YumK00/can-vehicle-platform/host/mobile-app/car.jpg

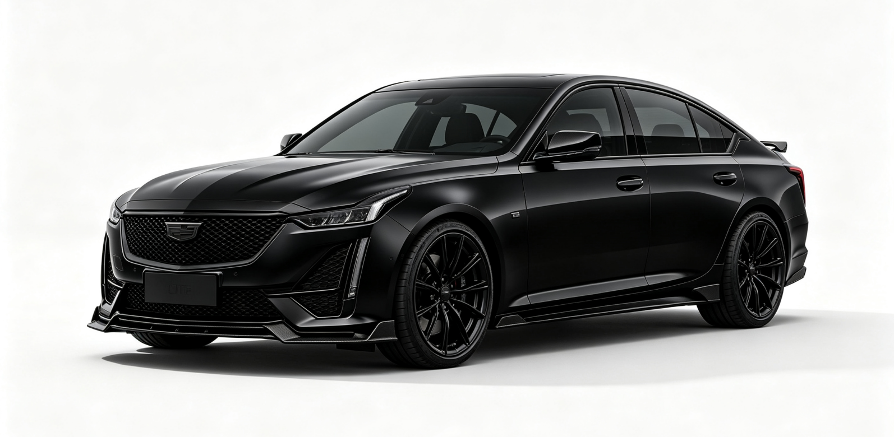
host/mobile-app/car.jpg
