YumK00/can-vehicle-platform/docs/can-protocol-and-wiring.md

# 通信协议设计 & 接线图（CAN + MQTT）v3.0

> **本文职责**：**协议全量定义** —— 帧格式、字节布局、滤波器、接线图、上电检查。
> 写代码时的速查映射见 `网关收发速查表.md`；入口见 `项目总纲.md`。
>
> **项目**：工业边缘智能网关（STM32F103 × N + ESP32-S3 网关）
> **节点**：`11111` = 节点 A（传感器） ｜ `22222` = 节点 B（执行器） ｜ ESP32-S3 = 网关
> **用途**：A、B、网关、USB-CAN 上位机都按本文档收发，抓帧就能对上号。
> **版本**：v3.0（修正 CAN ID 分配缺陷 + 重做 MQTT 主题设计）

---

# 〇、v2.0 → v3.0 修正了什么

审了一遍，**两处都是真问题**，不是审美偏好。

## 问题 1：CAN ID 按"节点"分组，扩展性和滤波都差

v2.0 的方案：A 用 `0x1xx`、B 用 `0x2xx`、控制指令用 `0x3xx`。

| 缺陷 | 后果 |
|---|---|
| **节点 C 没地方放** | `0x1xx`/`0x2xx` 给了 A/B，`0x3xx` 被控制指令占了 → 第三个节点只能挤到 `0x5xx`，很别扭 |
| **同类消息分散** | A 心跳 `0x180`、B 心跳 `0x280` 在不同组 → 网关想"收全所有心跳"，需要配**两个**滤波器组 |
| **两个维度混用** | 高 4 位有时表示节点（`0x1xx`）、有时表示功能（`0x3xx`）→ 规则不统一，没法一句话讲清 |

**根因**：我把「按节点分组」和「按功能分组」混在一起了。

**修正**：统一成 **按功能分组，节点号放低 4 位**。

## 问题 2：MQTT 主题把"传输方式"写进了层级

v2.0 的方案：`home/can/nodeA/sensor`、`home/can/cmd/motor`。

| 缺陷 | 后果 |
|---|---|
| **`can` 出现在主题里** | 阶段 1 加 Modbus 后，主题变成 `home/modbus/...`？→ 同一批数据分裂成两棵树 |
| **下行主题不含目标设备** | `home/can/cmd/motor` 所有设备都收到，靠 payload 里的 `target` 过滤 → 浪费带宽、容易误执行 |
| **没有 QoS / retained / LWT 约定** | 最危险的是**命令主题误用 retained**：新设备一连上就收到历史"开电机"命令并执行 |
| **`home` 前缀在公共 broker 上会撞车** | `broker.emqx.io` 是公共的，别人也能订阅 `home/#` 看到你的数据 |

**修正**：改成 `{项目前缀}/{网关}/{设备}/{类型}`，并补齐 QoS / retained / LWT 约定。

## 好消息：改动成本极低

你的代码里 ID 全是 **宏**（`CAN_ID_A_SENSOR`），MQTT 主题还没写进代码。

**所以这次修正只需要改 `protocol.h` 一个文件，不动任何业务逻辑。**

---

# 第一部分 · 总线物理层约定

| 项目 | 约定值 | 说明 |
|---|---|---|
| 帧格式 | **CAN 2.0A 标准帧**（11 位 ID） | 不用扩展帧 |
| 波特率 | **250 kbps** | 所有节点必须一致 |
| 位定时 | Prescaler=9、BS1=13TQ、BS2=2TQ、SJW=2TQ | `36MHz/(9×16)=250k`，采样点 87.5% |
| 模式 | **Normal**（两边都是） | ❌ 不用 Listen-Only，那样不回 ACK，对方会进 bus-off |
| 拓扑 | 总线型（手拉手），不要星型 | 分支线 < 30cm |
| 线材 | 双绞线（CANH/CANL 一对） | |
| 终端电阻 | **120Ω × 2**，加在物理最远两端 | 中间节点不加 |
| 共地 | **所有节点必须共 GND** | |

---

# 第二部分 · CAN ID 分配（v3.0 新方案）

## 2.1 ID 结构

```
 bit:  10  9  8  7  6  5  4 │ 3  2  1  0
      ┌────────────────────┼───────────┐
      │   功能组（高 7 位） │ 节点号(4位)│
      └────────────────────┴───────────┘
```

**节点号**：`0` = 广播 ｜ `1` = 节点A ｜ `2` = 节点B ｜ `3` = 网关 ｜ `4~15` 预留

**功能组**（ID 越小优先级越高）：

| 功能组 | ID 形式 | 用途 | 优先级 | 周期 |
|---|---|---|---|---|
| 紧急安全 | `0x001` | 急停（固定 ID，广播） | **最高** | 事件 |
| 事件报警 | `0x01n` | 阈值触发、故障 | 高 | 事件 |
| 周期数据 | `0x10n` | 传感器数据、执行器状态、网关状态 | 中高 | 100~1000ms |
| 控制指令 | `0x30n` | 电机命令（目标 = n） | 中 | 事件 |
| | `0x31n` | 目标值 / 阈值（目标 = n） | 中 | 事件 |
| | `0x32n` | PID 参数（目标 = n） | 中低 | 事件 |
| | `0x33n` | 模式 / 配置（目标 = n） | 中低 | 事件 |
| 心跳 | `0x70n` | 心跳（n = 节点） | 低 | 1000ms |
| 诊断升级 | `0x7E0` / `0x7E8` | 请求 / 应答（UDS 惯例） | 最低 | 事件 |

> **优先级设计理由**：
> 1. 急停最高 → 永远赢仲裁，不会被数据帧挤掉
> 2. 报警高于数据 → 异常要立刻出去，不能等下一个周期帧
> 3. 数据高于指令 → 周期数据是闭环控制的输入，硬实时；指令是事件性的，人感知不到 1ms 级差异
> 4. 心跳最低 → 1Hz、超时判定 3 秒，延迟几百 ms 完全无影响（CANopen 也把心跳放在最低组 `0x700+n`）
> 5. 诊断最低 → 只在维护时用

## 2.2 本项目实际用到的 ID

**✅ = 现在就要用 ｜ ⬜ = 预留（阶段 2/4 再实现）**

| ID | 名称 | 方向 | DLC | 周期 | 状态 |
|----|---|---|-----|---|---|
| `0x001` | `ESTOP` 急停 | 任意 → 广播 | 1 | 事件 | ✅ |
| `0x011` | `ALARM_A` | A → 广播 | 3 | 事件 | ⬜ |
| `0x012` | `ALARM_B` | B → 广播 | 3 | 事件 | ⬜ |
| `0x101` | `A_SENSOR` 传感器数据 | A → 广播 | 5 | 100ms | ✅ |
| `0x102` | `B_STATUS` 执行器状态 | B → 广播 | 4 | 200ms | ✅ |
| `0x103` | `GW_STATUS` 网关状态 | 网关 → 广播 | 4 | 1000ms | ✅ |
| `0x301` | `CTRL_MOTOR` → 节点A | → A | 3 | 事件 | ⬜ |
| `0x302` | `CTRL_MOTOR` → 节点B | → B | 3 | 事件 | ✅ |
| `0x311` | `CTRL_TARGET` → 节点A | → A | 3 | 事件 | ⬜ |
| `0x312` | `CTRL_TARGET` → 节点B | → B | 3 | 事件 | ✅ |
| `0x322` | `CTRL_PID` → 节点B | → B | 7 | 事件 | ⬜ |
| `0x332` | `CTRL_MODE` → 节点B | → B | 2 | 事件 | ⬜ |
| `0x701` | `A_HEARTBEAT` | A → 广播 | 2 | 1000ms | ✅ |
| `0x702` | `B_HEARTBEAT` | B → 广播 | 2 | 1000ms | ✅ |
| `0x703` | `GW_HEARTBEAT` | 网关 → 广播 | 2 | 1000ms | ✅ |
| `0x7E0` | `DIAG_REQ` 诊断/升级请求 | → 目标 | ≤8 | 事件 | ⬜ |
| `0x7E8` | `DIAG_RSP` 诊断/升级应答 | 目标 → | ≤8 | 事件 | ⬜ |

> **从 v2.0 迁移**：`A_SENSOR 0x100→0x101`、`B_STATUS 0x200→0x102`、`A_HB 0x180→0x701`、`B_HB 0x280→0x702`。**只改 `protocol.h`。**

## 2.3 加节点有多容易（这就是修正的价值）

想加一个"节点 C（电流采集）"：

```
0x10C   节点C 的周期数据
0x70C   节点C 的心跳
0x30C   给节点C 的控制指令
```

**只加 3 个宏，分组规则一个字不用改。** v2.0 方案下你得重新想"0x5xx 还是插进 0x1xx"。

---

# 第三部分 · 帧定义

## 3.1 `0x101` A_SENSOR（核心帧）

| 字节 | 内容 | 说明 |
|---|---|---|
| B0 | 红外 **高**字节 | uint16 **大端** |
| B1 | 红外 **低**字节 | |
| B2 | 光敏 **高**字节 | uint16 **大端** |
| B3 | 光敏 **低**字节 | |
| B4 | 序列号 SEQ | 0~255 循环，用于丢帧统计 |

- **DLC = 5**，周期 **100ms**
- **方向提醒**：光敏读数越大 = **越暗**；红外读数越大 = **无遮挡**

## 3.2 `0x102` B_STATUS

| 字节 | 内容 | 取值 |
|---|---|---|
| B0 | 电机状态 | 0=停 ／ 1=正转 ／ 2=反转 |
| B1 | PWM | 0~100 |
| B2 | 工作模式 | 0=手动 ／ 1=自动(PID) |
| B3 | 状态位 | bit0 通信正常 ／ bit1 阈值触发 ／ bit2 报警 |

- **DLC = 4**，周期 **200ms**

## 3.3 `0x103` GW_STATUS

| 字节 | 内容 | 取值 |
|---|---|---|
| B0 | WiFi 状态 | 0=断 ／ 1=连 |
| B1 | MQTT 状态 | 0=断 ／ 1=连 |
| B2-B3 | 缓存条数 | uint16 大端（断网缓存里积压多少条） |

- **DLC = 4**，周期 **1000ms**

## 3.4 心跳 `0x701` / `0x702` / `0x703`

| 字节 | 内容 |
|---|---|
| B0 | 魔数：A=`0xA5` ／ B=`0x5A` ／ 网关=`0xC3` |
| B1 | 心跳计数 0~255 |

- **DLC = 2**，周期 **1000ms**

## 3.5 `0x001` ESTOP 急停

| 字节 | 内容 |
|---|---|
| B0 | `0x01` |

- **DLC = 1**，事件触发
- ID 最小 → **总线上必赢仲裁**，永远不会被数据帧挤掉

## 3.6 `0x302` CTRL_MOTOR → B

| 字节 | 内容 | 取值 |
|---|---|---|
| B0 | 命令 | 0=停 ／ 1=正转 ／ 2=反转 ／ 3=设速 |
| B1 | 参数 | 速度 0~100 |
| B2 | 命令序号 | 0~255，用于幂等/去重 | 

> **注意**：v2.0 里 B0 是"目标节点"，**新方案里目标节点已经在 ID 低 4 位了**，所以 B0 空出来给命令。
> **这就是分组的价值**：ID 表达"发给谁"，payload 表达"干什么"，职责不重叠。

## 3.7 `0x312` CTRL_TARGET → B

| 字节 | 内容 |
|---|---|
| B0-B1 | 目标光照值（uint16 大端，0~4095） |
| B2 | 命令序号 |

## 3.8 `0x322` CTRL_PID → B（预留）

| 字节 | 内容 |
|---|---|
| B0-B1 | Kp × 100（uint16 大端） |
| B2-B3 | Ki × 100 |
| B4-B5 | Kd × 100 |
| B6 | 命令序号 |

## 3.9 `0x332` CTRL_MODE → B（预留）

| 字节 | 内容 |
|---|---|
| B0 | 模式 0=手动 ／ 1=自动 |
| B1 | 命令序号 |

## 3.10 `0x011` / `0x012` ALARM（预留，阶段 2）

| 字节 | 内容 |
|---|---|
| B0 | 报警码（1=传感器故障 2=通信丢失 3=阈值越界 4=执行器故障） |
| B1 | 附加数据高字节 |
| B2 | 附加数据低字节 |

- **为什么要独立于状态帧**：报警要**立刻**发出，不能等下一个 200ms 状态帧。这是实时性设计。

---

# 第四部分 · 编码约定与示例

## 4.1 约定

- **多字节一律大端**（高字节在前），与 CANopen / J1939 一致
- **传感器值**：直接用 ADC 原始值 0~4095（uint16）
- **百分比**：uint8，0~100
- **PID 参数**：uint16 = 实际值 × 100，不允许负数
- **序列号**：uint8，每发一帧 +1，到 255 归 0
- **魔数**：A=`0xA5`、B=`0x5A`、网关=`0xC3`
- **未定义的 ID 一律静默忽略**

## 4.2 字节级示例（拿 USB-CAN 一比就对）

| 场景 | 抓到的帧 | 解读 |
|---|---|---|
| 红外 3854、光敏 1030、第 7 帧 | `0x101` DLC=5 `0F 0E 04 06 07` | 0x0F0E=3854；0x0406=1030；SEQ=7 |
| 红外被挡 | `0x101` DLC=5 `00 B4 04 06 08` | 0x00B4=180 |
| B 正转 60% | `0x102` DLC=4 `01 3C 00 01` | 正转；0x3C=60；手动；通信正常 |
| 网关：WiFi+MQTT 都连上、缓存 12 条 | `0x103` DLC=4 `01 01 00 0C` | 0x000C=12 |
| A 心跳第 3 次 | `0x701` DLC=2 `A5 03` | |
| 手机让 B 正转 60% | `0x302` DLC=3 `01 3C 05` | 命令1=正转；速度60；序号5 |
| 下发目标光照 3000 给 B | `0x312` DLC=3 `0B B8 06` | 0x0BB8=3000 |
| 急停 | `0x001` DLC=1 `01` | |

**验算**：3854=0x0F0E ✓ ｜ 1030=0x0406 ✓ ｜ 3000=0x0BB8 ✓ ｜ 12=0x000C ✓

---

# 第五部分 · 接收滤波器（新方案下好配多了）

## 5.1 32 位掩码模式的正确写法

标准 ID 必须**左移 5 位**放进高半字 —— 这是最容易写错的地方。

```c
/* 精确匹配单个 ID */
#define FLT_ID(id)    ((uint32_t)(id) << 5)
/* 匹配"功能组"，忽略低 4 位节点号：掩码高 7 位全 1，低 4 位全 0 */
#define FLT_GROUP(id) ((uint32_t)((id) & 0x7F0) << 5)
```

## 5.2 各节点的滤波器配置

| 节点 | 想接收 | 滤波器组 | FilterIdHigh | FilterMaskIdHigh |
|---|---|---|---|---|
| **A** | 急停 `0x001` | Bank 0 | `0x001<<5` = `0x0020` | `0x7FF<<5` = `0xFFE0` |
| | 发给 A 的控制 `0x30n~0x33n` | Bank 1 | `0x300<<5` = `0x6000` | `0x700<<5` = `0xE000` |
| | 网关心跳 `0x703` | Bank 2 | `0x703<<5` = `0xE060` | `0xFFE0` |
| **B** | 急停 `0x001` | Bank 0 | `0x0020` | `0xFFE0` |
| | **A 的所有周期数据 + 心跳** `0x10n`、`0x70n` | Bank 1 | 见下 | |
| | 发给 B 的控制 `0x30n~0x33n` | Bank 2 | `0x6000` | `0xE000` |
| **网关** | 全部 | — | `ACCEPT_ALL` | 网关要做协议翻译，全收 |

**Bank 1（B 收 A 的数据）需要两个匹配**：`0x10x` 和 `0x70x`。因为它们是两个不同的功能组，用**列表模式**更合适：

```c
/* 列表模式：一次配两个精确 ID */
sFilterConfig.FilterMode      = CAN_FILTERMODE_IDLIST;
sFilterConfig.FilterScale     = CAN_FILTERSCALE_32BIT;
sFilterConfig.FilterIdHigh    = (0x101 << 5);   /* 第一个 ID */
sFilterConfig.FilterIdLow     = (0x701 << 5);   /* 第二个 ID */
sFilterConfig.FilterMaskIdHigh= 0;
sFilterConfig.FilterMaskIdLow = 0;
```

> **这就是分组的价值体现**：v2.0 里 A 的心跳 `0x180` 和数据 `0x100` 虽然同组，但 B 的心跳 `0x280` 却在另一组，网关想收全心跳必须配两个组。新方案里 `0x70n` 就是"所有心跳"，一个掩码搞定。

> **建议**：先别急着收紧滤波器。用 `ACCEPT_ALL` 把链路跑通，**确认收发正常后再收紧** —— 否则你会分不清"是滤波器配错"还是"根本没通信"。

---

# 第六部分 · MQTT 主题设计

> **完整的主题表与下行命令清单见 `网关收发速查表.md` 第 4、5 节**，
> 本节只讲**设计原则和理由**，不重复表格。

## 6.1 主题结构（已实现的方案）

```
{前缀} / {设备} / {类型}

 gw01  / nodeA  / telemetry
```

- **前缀**：`MQTT_PREFIX` 一个宏，含网关标识（当前 `"gw01"`）
- **设备**：`nodeA` / `nodeB` / `gateway` ／ 下行另有 `all`
- **类型**：上行 `telemetry` / `alert` / `status` / `stats`；下行 `cmd/<命令类型>`

> **完整前缀 = `gw01`**（代码里的 `MQTT_PREFIX` 宏），三个节点共用同一棵主题树。

## 6.2 上行主题（设备 → 云）

| 主题 | QoS | Retained | 触发 | 状态 |
|---|-----|---|---|---|
| `{p}/nodeA/telemetry` | 0 | ❌ | 收到 CAN `0x101` | ✅ 已实现 |
| `{p}/nodeB/telemetry` | 0 | ❌ | 收到 CAN `0x102` | ✅ 已实现 |
| `{p}/nodeA/alert` | 0 | ❌ | 收到 CAN `0x011` | ✅ 已实现 |
| `{p}/nodeB/alert` | 0 | ❌ | 收到 CAN `0x012` | ✅ 已实现 |
| `{p}/gateway/status` | 0 | ❌ | 每 5 秒 | ✅ 已实现 |
| `{p}/nodeA/status` | 1 | **✅** | 在线状态**翻转时** | ⬜ 待做 |
| `{p}/nodeB/status` | 1 | **✅** | 同上 | ⬜ 待做 |
| `{p}/gateway/stats` | 0 | ❌ | 每 10 秒 | ⬜ 待做（阶段 2） |

> **为什么 `telemetry` 不用 retained**：高频数据，retained 只保留最后一条，没意义还占 broker 存储。
> **为什么 `status` 要用 retained**：新订阅者一连上就立刻知道设备当前状态，不用干等下一次心跳。

## 6.3 下行主题：命令类型放主题里，不用 JSON ⭐

**实际实现**：

```
{p}/{节点}/cmd/{命令类型}          网关订阅  {p}/+/cmd/#

{p}/nodeB/cmd/motor     payload "1,50"        → 0x302
{p}/nodeB/cmd/target    payload "2000"        → 0x312
{p}/nodeB/cmd/pid       payload "1.5,0.2,0"   → 0x322
{p}/nodeB/cmd/mode      payload "1"           → 0x332
{p}/all/cmd/estop       payload 任意           → 0x001
```

**为什么这样比"单一 cmd 主题 + JSON payload"好**：

| | 单一 cmd + JSON | **主题分层 + 纯数据**（已采用） |
|---|---|---|
| MCU 侧代码 | 要写 JSON 解析器 | **零解析，`sscanf` 几行搞定** |
| 内存占用 | 解析器 + 缓冲 | 几乎为零 |
| 可读性 | 展开 JSON 才知道干什么 | 看主题就知道 |
| 通配订阅 | 只能全订 | 可精确订 `+/cmd/motor` |

CAN 侧已经按功能组拆好了（`GRP_CTRL_MOTOR` / `GRP_CTRL_PID`…），
MQTT 侧跟着拆，是**同一套划分的两个出口**。

> **完整命令清单（7 条，含 payload 取值）见 `网关收发速查表.md` 第 5 节。**

> ⚠️ **`all` 只建议用于 `estop`**：广播控制动作很危险（"所有节点一起开电机"基本不是你想要的），
> 而且会生成协议里没定义的 `0x300`。建议在 `can_bridge_mqtt` 里加一条限制。

## 6.4 ⚠️ 命令主题绝对不能 retained

retained 会让**每一个新订阅者一连上就收到最后一条命令并执行**。
想象一下网关重启后立刻执行三天前的"电机正转"——**这是 MQTT 主题设计里最经典的坑**。

→ 发命令时 `retain` 必须传 **0**。

## 6.5 订阅关系

| 谁 | 订阅 | 收到什么 |
|----|---|---|
| **网关** | `{p}/+/cmd/#` | 所有设备的命令 |
| **手机 App** | `{p}/#` | 全部 |
| **数据入库** | `{p}/+/telemetry` | 只收遥测 |
| **告警看板** | `{p}/+/alert` | 只收告警 |

## 6.6 LWT 遗嘱（⬜ 待做）

连接 broker 时声明遗嘱：**网关断线时 broker 自动代为发布**。

```c
static char s_lwt_topic[64];      /* ★ 必须 static：cfg 里存的是指针 */
snprintf(s_lwt_topic, sizeof(s_lwt_topic), "%s/gateway/status", MQTT_PREFIX);

esp_mqtt_client_config_t cfg = {
    .broker.address.uri = "mqtt://broker.emqx.io",
    .session.last_will = {
        .topic   = s_lwt_topic,
        .msg     = "{\"online\":false}",
        .msg_len = 16,
        .qos     = 1,
        .retain  = 1,          /* ★ 必须 retained，否则新订阅者看不到 */
    },
};
```

**效果**：网关一掉线，broker 立刻把 `gateway/status` 改成 `{"online":false}`，
**云端不需要自己判超时** —— 这是 MQTT 最实用的特性之一，面试可以讲。

## 6.7 Payload 设计

**已实现的 payload**（紧凑 JSON，不带空格，省带宽）：

```json
// {p}/nodeA/telemetry
{"ir":3854,"ldr":1030,"seq":42}

// {p}/nodeB/telemetry
{"motor":1,"pwm":60,"mode":0,"flags":1}

// {p}/nodeA/alert   ·   {p}/nodeB/alert
{"code":2,"extra":0}

// {p}/gateway/status
{"wifi":1,"mqtt":1,"cache":0}
```

**待做的 payload**（阶段 2）：

```json
// {p}/gateway/stats        —— 丢帧率统计做完后
{"rx":1234,"lost":3,"lost_rate":0.0024,"mqtt_drop":0,"uptime":3600,"heap":123456}

// {p}/nodeA/status（retained）
{"online":true,"lastseen":1696234567}
```

### 关于时间戳（⬜ 待做，一个真实的工程问题）

STM32 **没有 RTC，也没有对时**，所以只能提供**上电后的相对毫秒数**。现在的 payload 里没有时间戳。

**解决方案**：
- CAN 帧里带的是设备相对时间（用于算丢帧/间隔）
- **网关收到后用自己 SNTP 同步的 UTC 时间补上 `ts_gw`**，作为云端记录的依据

> 这就是"网关做语义转换"的具体体现 —— 它不只是转发，还负责**补全设备缺的信息**。
> 面试可以讲：*"设备无 RTC，时间戳由网关统一打，保证云端时序一致。"*

## 6.8 心跳要不要转发到 MQTT？

**不转发。** 设计决策：

- 心跳是**链路层**的存活检测，每秒一帧 × N 个节点，全转发到云端是纯浪费
- 网关自己判超时，然后**更新对应节点的 `status`（retained）里的 `online` 字段**
- 云端只看 retained 的 status 消息就知道在不在线

**收益**：MQTT 消息量大幅下降，云端也不用自己维护超时定时器。

---

# 第七部分 · CAN ↔ MQTT 映射表

| CAN 帧 | MQTT 主题 | 处理方式 |
|---|---|---|
| `0x101` A_SENSOR | `{p}/gw01/nodeA/telemetry` | 解析 → JSON → 发布 |
| `0x102` B_STATUS | `{p}/gw01/nodeB/telemetry` | 解析 → JSON → 发布 |
| `0x103` GW_STATUS | `{p}/gw01/gateway/status` | 合并进网关状态 |
| `0x701` A_HEARTBEAT | （**不转发**） | 只用于刷新 nodeA 的 online 状态 |
| `0x702` B_HEARTBEAT | （**不转发**） | 同上 |
| `0x703` GW_HEARTBEAT | （**不转发**） | 网关自身 |
| `0x001` ESTOP | `{p}/gw01/alert` | level=critical |
| `0x011/0x012` ALARM | `{p}/gw01/alert` | 预留 |
| — | `{p}/gw01/gateway/stats` | 网关本地统计，10 秒发一次 |
| `{p}/gw01/nodeB/cmd` | `0x302` / `0x312` / `0x322` | 按 `cmd` 字段选帧 |
| `{p}/gw01/broadcast/cmd` | `0x001` | 急停 |

**下行映射规则**：

| JSON 的 `cmd` | 发出的 CAN 帧 |
|---|---|
| `motor` | `0x302`（目标 B） |
| `target` | `0x312` |
| `pid` | `0x322` |
| `mode` | `0x332` |
| `estop` | `0x001` |

---

# 第八部分 · ⚠️ 现有代码的两个风险

## 8.1 `CAN_Send()` 里的 `Error_Handler()` 会死机

```c
if (HAL_CAN_AddTxMessage(...) != HAL_OK) Error_Handler();   // ← 危险
```

`Error_Handler()` = `__disable_irq(); while(1);`

**邮箱满（3 个发送邮箱都在用）是完全正常的情况**，不是致命错误。改成：

```c
uint8_t CAN_Send(uint32_t id, uint8_t *data, uint8_t length)
{
    if (length > 8) return 0;
    if (HAL_CAN_GetTxMailboxesFreeLevel(&hcan1) == 0) return 0;   /* 丢帧，不卡死 */
    ...
    return (HAL_CAN_AddTxMessage(...) == HAL_OK) ? 1 : 0;
}
```

## 8.2 两个节点的 `AutoRetransmission` 不一致

| 工程 | 当前 | 建议 |
|---|---|---|
| `11111` | `DISABLE` | 保持 |
| `22222` | `ENABLE` | **改成 `DISABLE`** |

**为什么**：B 加上心跳后，如果 A 关机，B 的心跳永远拿不到 ACK → `ENABLE` 会**无限重发** → 3 个邮箱占满 → `AddTxMessage` 失败 → 触发 8.1 的死循环。

---

# 第九部分 · 时序与安全

## 9.1 心跳与超时

```
A ──0x701(1s)──▶ 总线
B ──0x702(1s)──▶ 总线
网关 ──0x703(1s)──▶ 总线

B 端：3 秒收不到 0x701 → A 离线 → 停电机、LED 熄、OLED 显示"通信丢失"
A 端：3 秒收不到 0x702 → B 离线 → 报警
网关：任一节点心跳丢失 → 更新该节点 status 的 online=false → 发 alert
```

超时阈值 = 心跳周期的 **3 倍**。计数回绕用 `(now - last) & 0xFF` 处理。

## 9.2 安全状态（Fail-Safe）

| 触发条件 | 动作 |
|---|---|
| 收到 `0x001` | 立即停机 + 锁定，需人工复位 |
| 心跳超时 | 停机，显示"通信丢失"，恢复后自动回正常 |
| CAN bus-off | 停收发，自动恢复；期间保持安全状态 |
| 传感器值越界（长时间贴 0 或 4095） | 判定传感器故障 → 停 PID、上报告警 |
| MQTT 断连 | 数据转存断网缓存，**不影响 CAN 侧实时控制** |

---

# 第十部分 · 接线图

## 10.1 系统拓扑

```
        120Ω                                              120Ω
         ┌┐                                                ┌┐
    ┌────┴┴────┐      ┌──────────┐      ┌──────────┐  ┌────┴┴────┐
    │  节点 A  │      │  节点 B  │      │  网关    │  │ USB-CAN  │
    │  11111   │      │  22222   │      │ ESP32-S3 │  │  (PC)    │
    │  +TJA1050│      │  +TJA1050│      │ +TJA1050 │  │          │
    └────┬─────┘      └────┬─────┘      └────┬─────┘  └────┬─────┘
         │                 │                 │             │
   ══════╪═════════════════╪═════════════════╪═════════════╪══════  CANH
   ══════╪═════════════════╪═════════════════╪═════════════╪══════  CANL
        GND ────────────── GND ───────────── GND ──────── GND   （必须共地！）
```

## 10.2 STM32 ↔ TJA1050

| TJA1050 | STM32（A、B 相同） |
|---|---|
| TXD | **PA12**（CAN1_TX） |
| RXD | **PA11**（CAN1_RX） |
| VCC | **5V** |
| GND | 共地 |
| CANH / CANL | 总线 |
| S（pin8） | **接 GND**（否则可能进待机） |

## 10.3 网关 ESP32-S3（⚠️ RXD 必须分压）

```
ESP32-S3                          TJA1050
┌──────────────┐                 ┌────────┐
│ GPIO17 (TX)  ├─────────────────┤TXD     │
│ GPIO18 (RX)  ├──┐              │        │
│              │  └─[2.2kΩ]──┬───┤RXD     │
│              │           [3.3kΩ]│        │
│ GND ─────────┼─────────────┴───┤GND     │
│ 5V (VBUS)    ├─────────────────┤VCC     │
└──────────────┘                 └────────┘

分压：5V × 3.3k/(2.2k+3.3k) = 3.0V  →  低于 ESP32 的 3.6V 上限 ✓
```

**为什么必须分压**：TJA1050 的 RXD 输出约 5V，**ESP32-S3 的 GPIO 不是 5V 容忍**。
STM32F103 的 PA11/PA12 是 5V 容忍，所以 A/B 可以直接接。

### ⚠️ 最大的坑：收发器供电电压（本项目实际踩过）

**真 TJA1050 是 5V 器件**（datasheet: VCC 4.75~5.25V）。

**接 3.3V 时发射器被禁用、总线强制保持隐性**，现象是：

- TX 一直失败 → 很快 BUS_OFF
- 切 LISTEN_ONLY 也一帧收不到（只听模式对总线零影响）
- **量 RXD 引脚：3 秒 0 次电平跳变**（恒高）← 决定性证据

> **实测踩坑**：三个模块型号相同、接线相同，**唯独供电不同** ——
> 手头两个"3.3V 也能跑"的其实是 **3.3V/5V 兼容型号**，借来的第三个才是真 TJA1050，接 3.3V 死活不通。
> **肉眼看不出差别，量一下 VCC 就现形。**

**保险做法**：不管什么型号，**VCC 一律接 5V**，ESP32 侧统一加分压电阻。

---

# 第十一部分 · 上电前检查清单

- [ ] 所有 MCU 与 TJA1050 **共地**？
- [ ] TJA1050 的 VCC 是 **5V**（不是 3.3V）？
- [ ] 总线上**恰好 2 个 120Ω**？
- [ ] CANH 对 CANH、CANL 对 CANL，**没接反**？
- [ ] 所有节点波特率都是 **250kbps**？
- [ ] TJA1050 的 S 脚**接了 GND**？
- [ ] 网关的 RXD **过了分压**？
- [ ] 两边都是 **Normal 模式**（没误设 Listen-Only）？
- [ ] MQTT **命令主题没有设 retained**？

---

# 第十二部分 · 调试顺序

1. **各自回环自测**：`CAN_MODE_NORMAL` 临时改 `CAN_MODE_LOOPBACK`，一块板就能验证"发送→中断→接收"
2. **两块板直连**：A 发 `0x101`，B 的 OLED 应显示 `101 / 5 / 0F 0E 04 06 07`
3. **USB-CAN 抓帧**：字节与 4.2 节示例一致
4. **B 加心跳**：B 发 `0x702`，A 的 OLED 能看到
5. **B 解析并显示真实值**
6. **网关挂总线**：先只读不发，确认能解析
7. **网关上 MQTT**：手机看到的数据与 USB-CAN 一致
8. **手机下发命令**：验证下行链路

> 一次只加一个新东西，永远知道是谁坏了。
