YumK00/can-vehicle-platform/(commit log)

2026-11-06 feat: 整合为 CAN 总线采集-网关-上位机闭环平台
    - monorepo 结构：firmware（采集/执行/网关/门锁）+ host（桌面/手机）+ protocol + tools + docs
    - 单一真源 protocol/contract.json：生成 C/Qt 头文件，同步 6 份工程副本并做一致性校验
    - 主机侧协议自测 3548 条断言 + GitHub Actions 契约治理流水线
    - 桌面监控台新增真实网关模式：GatewayClient 订阅 gw0805/*，看板统计在线率/时延/丢帧率，命令 QoS1 下发
    - 手机 App 新增网关模式，与仿真模式互斥切换；远程急停/电机/模式控制
    - 网关 mqtt.h 主题与 mqtt.c broker 地址改为从契约派生，不再硬编码
    - 两个 STM32 工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
    [partitions-16MiB.csv]
2026-11-06 feat: 报警码纳入契约生成；补齐桌面端最终改动
    - contract_qt.h 新增 kAlarmXxx / kAlarmXxxName（来自 contract.json 的 alarm_codes），
    桌面端报警码显示不再手写映射，新增报警码只需改契约
    - 桌面监控台进入真实模式时清空上一轮残留数值，避免切过去先看到旧数据
    - 桌面端 README 定稿（两种模式、GatewayClient 信号表、指标口径、命令映射、构建与联调）
    - 主机侧自测增至 3557 条断言，6 份契约副本全部一致
